Dominus-Nova/wearable-dev-board-rp2040-wireless/RP2040 PCB.pdf

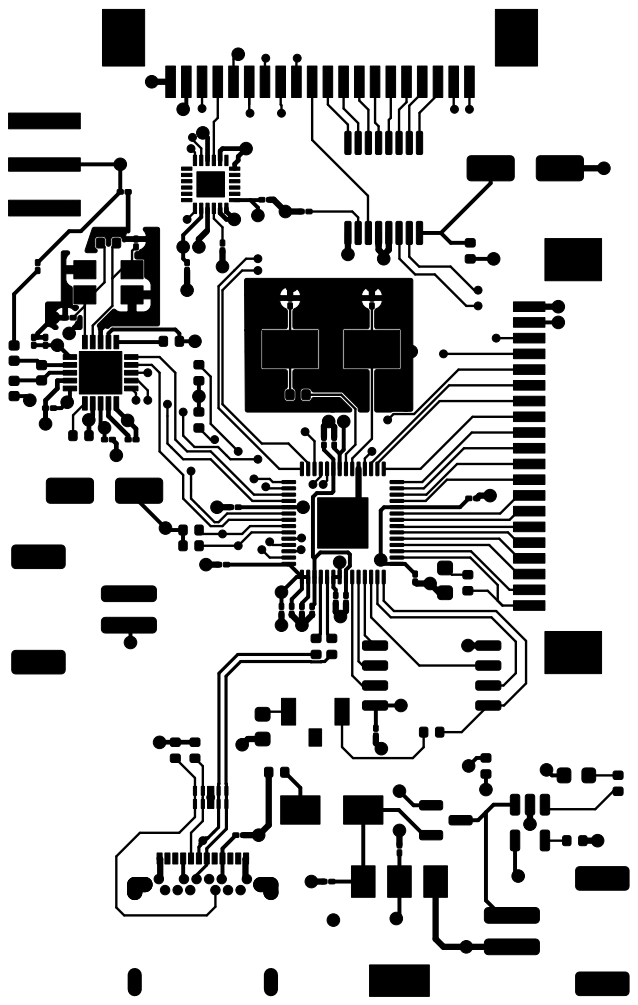
[picture p1: page 1]

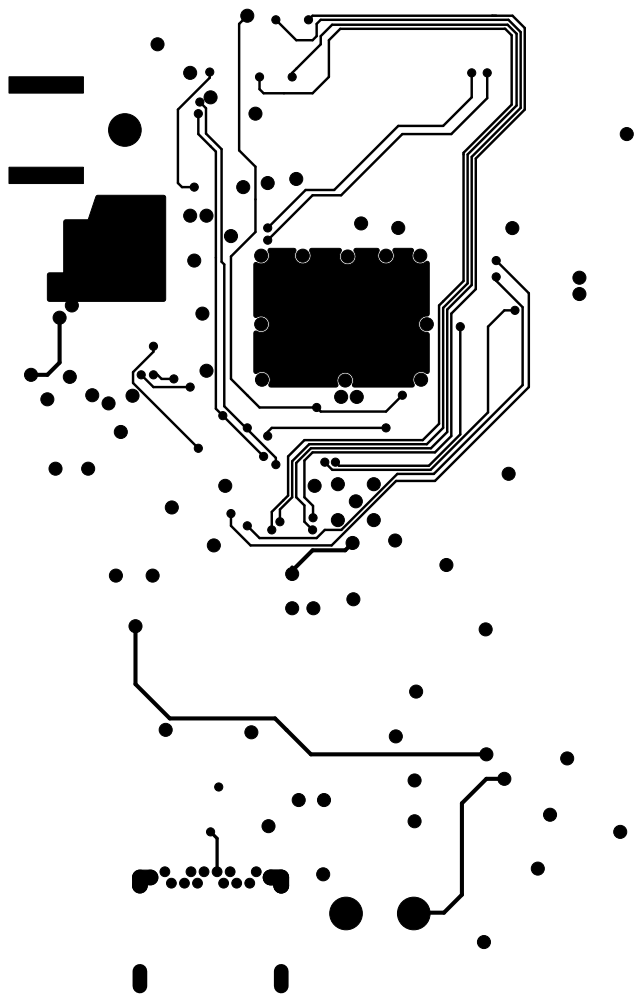
[picture p2: page 2]

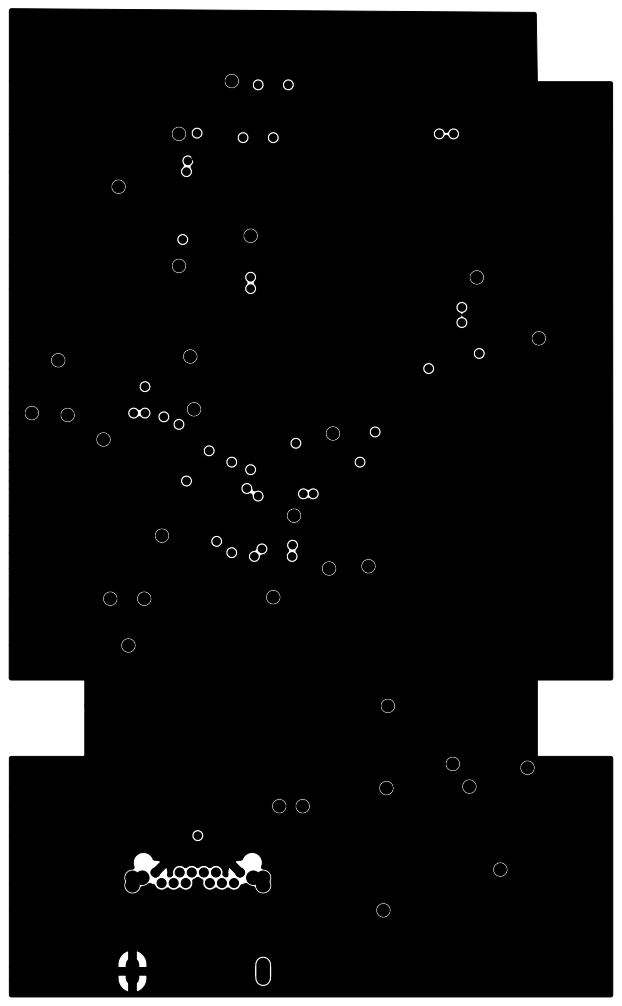
[picture p3: page 3]

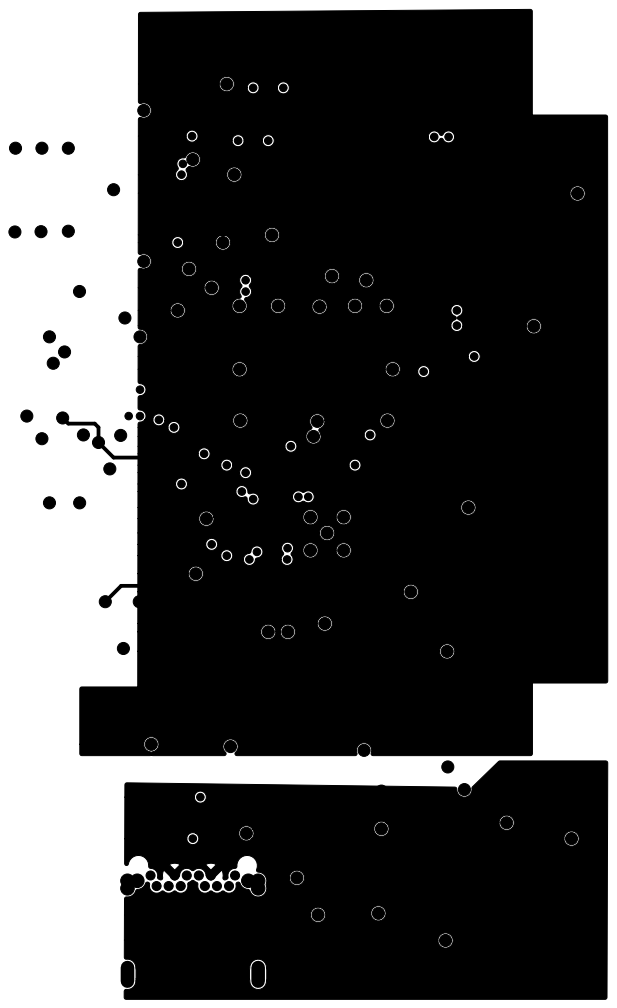
[picture p4: page 4]

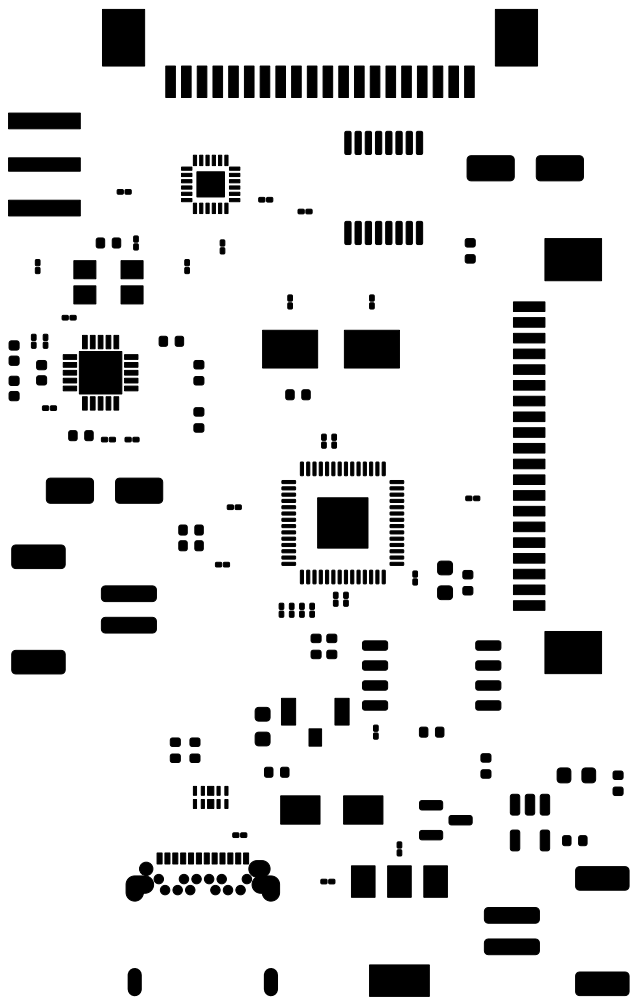
[picture p5: page 5]

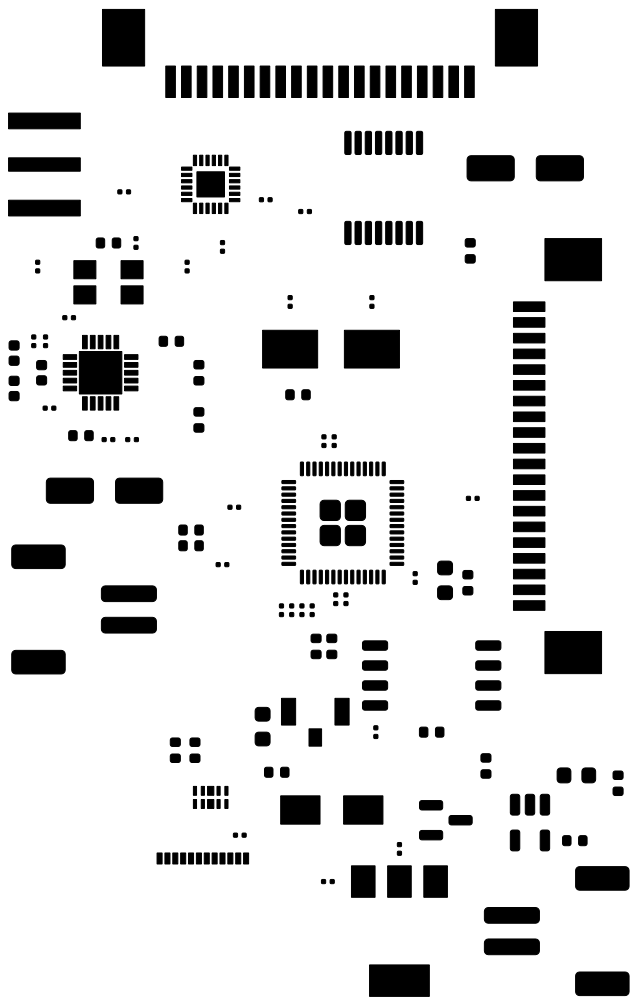
[picture p6: page 6]

# * R¹⁷

# J4 C7 C6

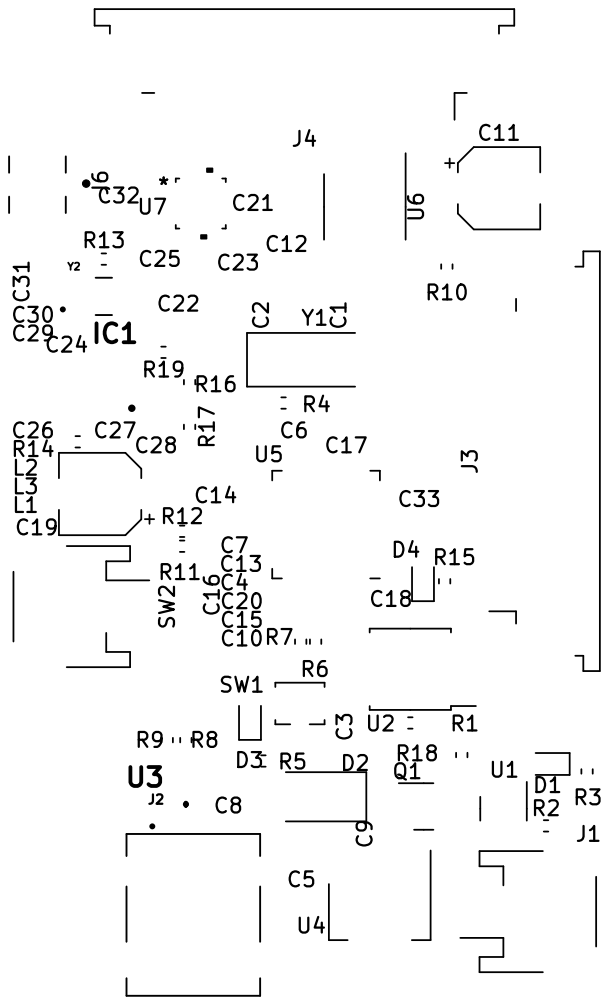
[picture p7: page 7]
