Dominus-Nova/wearable-dev-board-rp2040-wireless/Rp2040 wearable dev boards w wireless.kicad_pcb

## KiCad design Rp2040 wearable dev boards w wireless.kicad_pcb (2023-02-03)

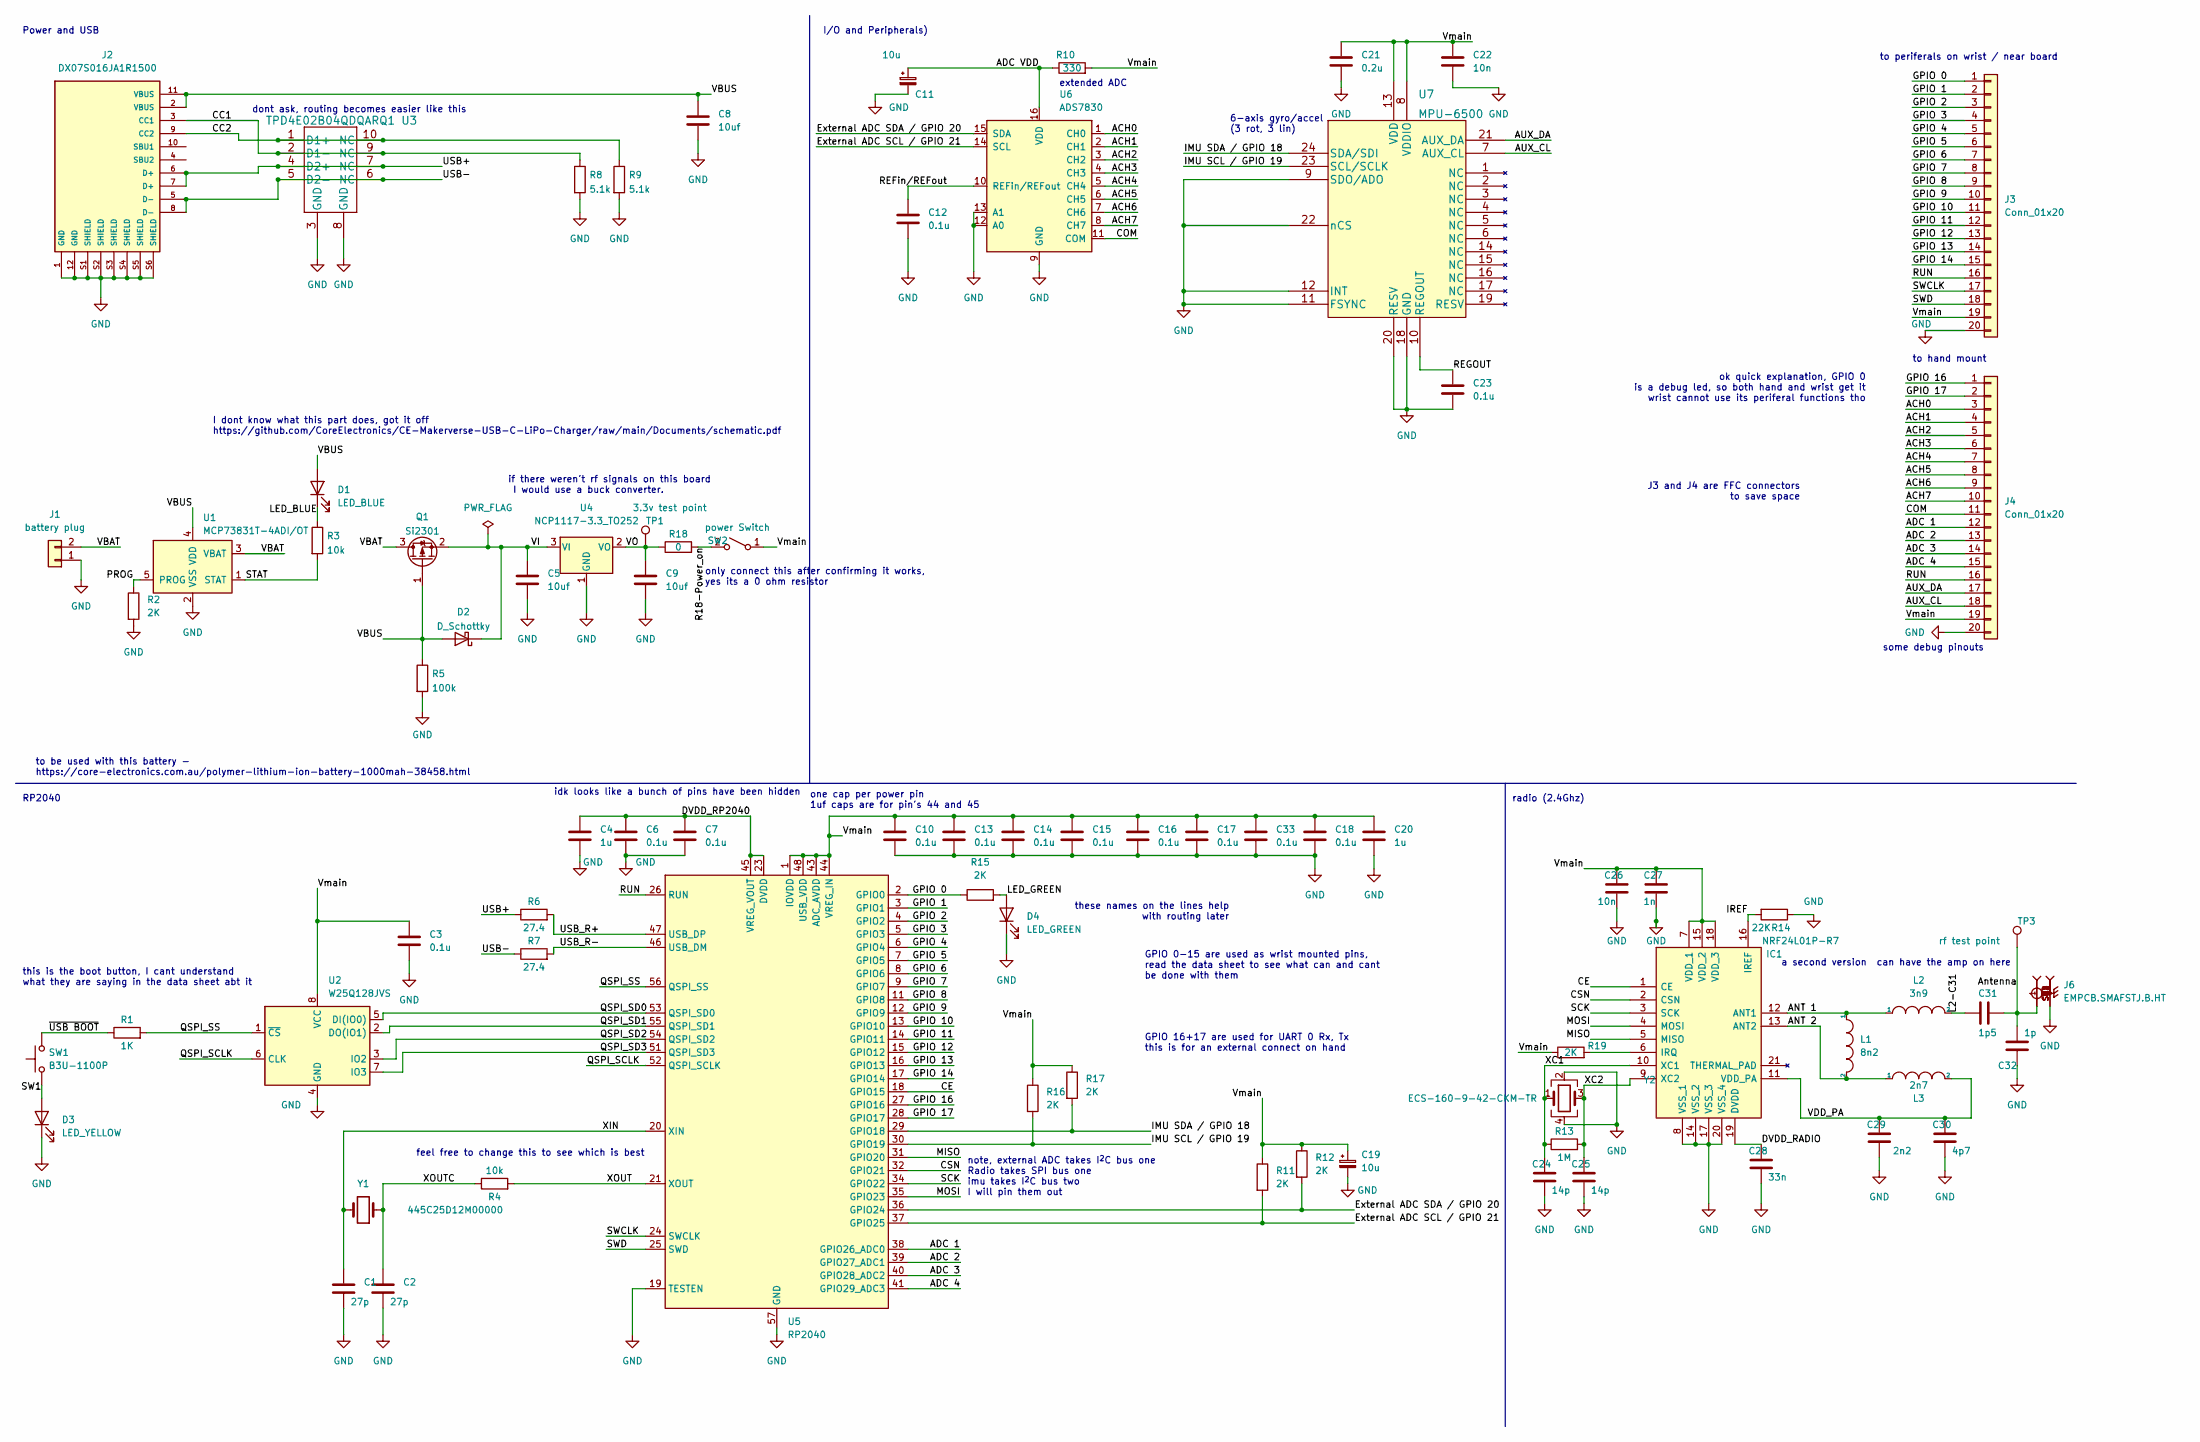
[picture p8: schematic Rp2040 wearable dev boards w wireless.kicad_sch, main]

Parts:
C1, C2: 27p; C_01005_0402Metric; Digikey Part Number 445-7173-6-ND
C3, C6, C7, C10, C12, C13, C14, C15, C16, C17, C18, C23, C33: 0.1u; C_0201_0603Metric; Digikey Part Number 490-3167-1-ND
C4, C20: 1u; C_0201_0603Metric; Digikey Part Number 478-7862-1-ND
C5, C8, C9: 10uf; C_0402_1005Metric; Digikey Part Number 490-GRM155R60J106ME05JCT-ND
C11, C19: 10u; CP_Elec_5x5.3; Digikey Part Number 732-6416-6-ND
C21: 0.2u; C_1206_3216Metric; Digikey Part Number 478-12814-1-ND
C22, C26: 10n; C_01005_0402Metric; Digikey Part Number 490-13319-1-ND
C24, C25: 14p; C_0402_1005Metric; Digikey Part Number 490-GJM1555C1H140FB01DCT-ND
C27: 1n; C_01005_0402Metric; Digikey Part Number 490-GRM022R71C102KE14LCT-ND
C28: 33n; C_01005_0402Metric; Digikey Part Number 490-9977-1-ND
C29: 2n2; C_01005_0402Metric; Digikey Part Number 490-7164-1-ND
C30: 4p7; C_01005_0402Metric; Digikey Part Number 490-13585-1-ND
C31: 1p5; C_01005_0402Metric; Digikey Part Number 490-13488-1-ND
C32: 1p; C_01005_0402Metric; Digikey Part Number 490-13474-1-ND
D1: LED_BLUE; LED_0603_1608Metric; Digikey Part Number 160-1827-1-ND
D2: D_Schottky; D_SMA; Digikey Part Number 641-1690-1-ND
D3: LED_YELLOW; LED_0603_1608Metric; Digikey Part Number 160-1448-1-ND
D4: LED_GREEN; LED_0603_1608Metric; Digikey Part Number 160-1446-1-ND
IC1: NRF24L01P-R7; QFN50P400X400X95-21N-D; Manufacturer_Part_Number NRF24L01P-R7; Mouser Part Number 949-NRF24L01P-R7
J1: battery plug; JST_PH_S2B-PH-SM4-TB_1x02-1MP_P2.00mm_Horizontal; Digikey Part Number 455-1749-1-ND
J2: DX07S016JA1R1500; JAE_DX07S016JA1R1500; PARTREV 1; Digikey Part Number 670-DX07S016JA1R1500CT-ND
J3, J4: Conn_01x20; TE_2-84952-0_1x20-1MP_P1.0mm_Horizontal; Digikey Part Number A100319CT-ND
J6: EMPCB.SMAFSTJ.B.HT; TAOGLAS_EMPCB.SMAFSTJ.B.HT; Digikey Part Number 931-1175-ND
L1: 8n2; L_0402_1005Metric; Digikey Part Number 490-6849-1-ND
L2: 3n9; L_0402_1005Metric; Digikey Part Number 490-6813-1-ND
L3: 2n7; L_0402_1005Metric; Digikey Part Number 490-6799-1-ND
Q1: Si2301; SOT-23; Digikey Part Number 353-SI2301A-TPCT-ND
R1: 1K; R_0402_1005Metric; Digikey Part Number 311-1.0KJRCT-ND
R2, R11, R12, R15, R16, R17, R19: 2K; R_0402_1005Metric; Digikey Part Number YAG2303CT-ND
R3, R4: 10k; R_0402_1005Metric; Digikey Part Number 311-10KJRCT-ND
R5: 100k; R_0402_1005Metric; Digikey Part Number 13-RC0402FR-13100KLCT-ND
R6, R7: 27.4; R_0402_1005Metric; Digikey Part Number YAG3085CT-ND
R8, R9: 5.1k; R_0402_1005Metric; Digikey Part Number 13-RC0402FR-135K1LCT-ND
R10: 330; R_0402_1005Metric; Digikey Part Number 311-330JRCT-ND
R13: 1M; R_0402_1005Metric; Digikey Part Number 311-1.0MJRCT-ND
R14: 22K; R_0402_1005Metric; Digikey Part Number 311-22.0KLRCT-ND
R18: 0; R_0402_1005Metric; Digikey Part Number 311-0.0LRCT-ND
SW1: B3U-1100P; SW_SPST_B3U-1100P; Digikey Part Number SW1021CT-ND
SW2: power Switch; JST_PH_S2B-PH-SM4-TB_1x02-1MP_P2.00mm_Horizontal; Digikey Part Number 455-1749-1-ND
TP1: 3.3v test point; TestPoint_Pad_D2.0mm; Digikey Part Number n/a
TP3: rf test point; TestPoint_Pad_D2.0mm; Digikey Part Number n/a
U1: MCP73831T-4ADI/OT; SOT-23-5; Digikey Part Number MCP73831T-4ADI/OTCT-ND
U2: W25Q128JVS; SOIC-8_5.23x5.23mm_P1.27mm; Digikey Part Number W25Q128JVSIMCT-ND
U3: TPD4E02B04QDQARQ1; Digikey Part Number 296-48995-1-ND
U4: NCP1117-3.3_TO252; SOT-223; Digikey Part Number NCP1117LPST33T3GOSCT-ND
U5: RP2040; QFN-56-1EP_7x7mm_P0.4mm_EP3.2x3.2mm; Digikey Part Number 2648-SC0914(13)CT-ND
U6: ADS7830; TSSOP-16_4.4x5mm_P0.65mm; Digikey Part Number 296-25899-1-ND
U7: MPU-6500; Digikey Part Number 1428-1011-1-ND
Y1: 445C25D12M00000; Crystal_SMD_5032-2Pin_5.0x3.2mm_HandSoldering; Digikey Part Number CTX1162CT-ND
Y2: ECS-160-9-42-CKM-TR; XTAL_ECS-160-9-42-CKM-TR; Digikey Part Number XC1611CT-ND

Connections:
/ACH0: J4.3, U6.1 (CH0)
/ACH1: J4.4, U6.2 (CH1)
/ACH2: J4.5, U6.3 (CH2)
/ACH3: J4.6, U6.4 (CH3)
/ACH4: J4.7, U6.5 (CH4)
/ACH5: J4.8, U6.6 (CH5)
/ACH6: J4.9, U6.7 (CH6)
/ACH7: J4.10, U6.8 (CH7)
/ADC 1: J4.12, U5.38 (GPIO26_ADC0)
/ADC 2: J4.13, U5.39 (GPIO27_ADC1)
/ADC 3: J4.14, U5.40 (GPIO28_ADC2)
/ADC 4: J4.15, U5.41 (GPIO29_ADC3)
/ADC VDD: C11.1, R10.1, U6.16 (VDD)
/ANT 1: IC1.12 (ANT1), L1.1, L2.1
/ANT 2: IC1.13 (ANT2), L1.2, L3.1
/AUX_CL: J4.18, U7.7 (AUX_CL)
/AUX_DA: J4.17, U7.21 (AUX_DA)
/Antenna: C31.2, C32.1, J6.1, TP3.1; also elsewhere on the board
/CC1: J2.3 (CC1), R8.1, U3.2 (D1-), U3.9 (NC)
/CC2: J2.9 (CC2), R9.1, U3.1 (D1+), U3.10 (NC)
/CE: IC1.1 (CE), U5.18 (GPIO15)
/COM: J4.11, U6.11 (COM)
/CSN: IC1.2 (CSN), U5.32 (GPIO21)
/DVDD_RADIO: C28.1, IC1.19 (DVDD)
/DVDD_RP2040: C4.1, C6.1, C7.1, U5.23 (DVDD), U5.45 (VREG_VOUT), U5.50 (DVDD)
/External ADC SCL / GPIO 21: R11.2, U5.37 (GPIO25), U6.14 (SCL)
/External ADC SDA / GPIO 20: R12.2, U5.36 (GPIO24), U6.15 (SDA)
/GPIO 0: J3.1, R15.1, U5.2 (GPIO0)
/GPIO 1: J3.2, U5.3 (GPIO1)
/GPIO 2: J3.3, U5.4 (GPIO2)
/GPIO 3: J3.4, U5.5 (GPIO3)
/GPIO 4: J3.5, U5.6 (GPIO4)
/GPIO 5: J3.6, U5.7 (GPIO5)
/GPIO 6: J3.7, U5.8 (GPIO6)
/GPIO 7: J3.8, U5.9 (GPIO7)
/GPIO 8: J3.9, U5.11 (GPIO8)
/GPIO 9: J3.10, U5.12 (GPIO9)
/GPIO 10: J3.11, U5.13 (GPIO10)
/GPIO 11: J3.12, U5.14 (GPIO11)
/GPIO 12: J3.13, U5.15 (GPIO12)
/GPIO 13: J3.14, U5.16 (GPIO13)
/GPIO 14: J3.15, U5.17 (GPIO14)
/GPIO 16: J4.1, U5.27 (GPIO16)
/GPIO 17: J4.2, U5.28 (GPIO17)
/IMU SCL / GPIO 19: R16.2, U5.30 (GPIO19), U7.23 (SCL/SCLK)
/IMU SDA / GPIO 18: R17.2, U5.29 (GPIO18), U7.24 (SDA/SDI)
/IREF: IC1.16 (IREF), R14.2
/L2-C31: C31.1, L2.2
/LED_BLUE: D1.1 (K), R3.1
/LED_GREEN: D4.2 (A), R15.2
/MISO: IC1.5 (MISO), U5.31 (GPIO20)
/MOSI: IC1.4 (MOSI), U5.35 (GPIO23)
/PROG: R2.1, U1.5 (PROG)
/QSPI_SCLK: U2.6 (CLK), U5.52 (QSPI_SCLK)
/QSPI_SD0: U2.5 (DI(IO0)), U5.53 (QSPI_SD0)
/QSPI_SD1: U2.2 (DO(IO1)), U5.55 (QSPI_SD1)
/QSPI_SD2: U2.3 (IO2), U5.54 (QSPI_SD2)
/QSPI_SD3: U2.7 (IO3), U5.51 (QSPI_SD3)
/QSPI_SS: R1.2, U2.1 (~CS), U5.56 (QSPI_SS)
/R18-Power_on: R18.2, SW2.2 (B)
/REFin/REFout: C12.1, U6.10 (REFin/REFout)
/REGOUT: C23.1, U7.10 (REGOUT)
/RUN: J3.16, J4.16, U5.26 (RUN)
/SCK: IC1.3 (SCK), U5.34 (GPIO22)
/STAT: R3.2, U1.1 (STAT)
/SW1: D3.2 (A), SW1.1
/SWCLK: J3.17, U5.24 (SWCLK)
/SWD: J3.18, U5.25 (SWD)
/USB+: J2.6 (D+), J2.7 (D+), R6.1, U3.4 (D2+), U3.7 (NC)
/USB-: J2.5 (D-), J2.8 (D-), R7.1, U3.5 (D2-), U3.6 (NC)
/USB_R+: R6.2, U5.47 (USB_DP)
/USB_R-: R7.2, U5.46 (USB_DM)
/VBAT: J1.2, Q1.3 (D), U1.3 (VBAT)
/VBUS: C8.1, D1.2 (A), D2.2 (A), J2.2 (VBUS), J2.11 (VBUS), Q1.1 (G), R5.1, U1.4 (VDD)
/VDD_PA: C29.1, C30.1, IC1.11 (VDD_PA), L3.2
/VI: C5.1, D2.1 (K), Q1.2 (S), U4.3 (VI)
/VO: C9.1, R18.1, TP1.1, U4.2 (VO)
/Vmain: C3.1, C10.1, C13.1, C14.1, C15.1, C16.1, C17.1, C18.1, C19.1, C20.1, C21.1, C22.1, C26.1, C27.1, C33.1, IC1.7 (VDD_1), IC1.15 (VDD_2), IC1.18 (VDD_3), J3.19, J4.19, R10.2, R11.1, R12.1, R16.1, R17.1, R19.1, SW2.1 (A), U2.8 (VCC), U5.1 (IOVDD), U5.10 (IOVDD), U5.22 (IOVDD), U5.33 (IOVDD), U5.42 (IOVDD), U5.43 (ADC_AVDD), U5.44 (VREG_IN), U5.48 (USB_VDD), U5.49 (IOVDD), U7.8 (VDDIO), U7.13 (VDD)
/XC1: C24.1, IC1.10 (XC1), R13.1, Y2.1
/XC2: C25.1, IC1.9 (XC2), R13.2, Y2.3
/XIN: C1.1, U5.20 (XIN), Y1.2
/XOUT: R4.2, U5.21 (XOUT)
/XOUTC: C2.1, R4.1, Y1.1
/~USB BOOT: R1.1, SW1.2
GND: C1.2, C2.2, C3.2, C4.2, C5.2, C6.2, C7.2, C8.2, C9.2, C10.2, C11.2, C12.2, C13.2, C14.2, C15.2, C16.2, C17.2, C18.2, C19.2, C20.2, C21.2, C22.2, C23.2, C24.2, C25.2, C26.2, C27.2, C28.2, C29.2, C30.2, C32.2, C33.2, D3.1 (K), D4.1 (K), IC1.8 (VSS_1), IC1.14 (VSS_2), IC1.17 (VSS_3), IC1.20 (VSS_4), J1.1, J2.1 (GND), J2.12 (GND), J2.S1 (SHIELD), J2.S2 (SHIELD), J2.S3 (SHIELD), J2.S4 (SHIELD), J2.S5 (SHIELD), J2.S6 (SHIELD), J3.20, J4.20, J6.SH1, J6.SH2, J6.SH3, J6.SH4, R2.2, R5.2, R8.2, R9.2, R14.1, U1.2 (VSS), U2.4 (GND), U3.3 (GND), U3.8 (GND), U4.1 (GND), U5.19 (TESTEN), U5.57 (GND), U6.9 (GND), U6.12 (A0), U6.13 (A1), U7.9 (SDO/ADO), U7.11 (FSYNC), U7.12 (INT), U7.18 (GND), U7.20 (RESV), U7.22 (nCS), Y2.2, Y2.4; also elsewhere on the board
unnamed: IC1.6 (IRQ), R19.2

Notes on the sheet:
I dont know what this part does, got it off https://github.com/CoreElectronics/CE-Makerverse-USB-C-LiPo-Charger/raw/main/Documents/schematic.pdf
6-axis gyro/accel (3 rot, 3 lin)
dont ask, routing becomes easier like this
radio (2.4Ghz)
if there weren't rf signals on this board I would use a buck converter.
note, external ADC takes I^{2}C bus one Radio takes SPI bus one imu takes I^{2}C bus two I will pin them out
this is the boot button, I cant understand what they are saying in the data sheet abt it
idk looks like a bunch of pins have been hidden
a second version can have the amp on here
extended ADC
I/O and Peripherals)
RP2040
these names on the lines help with routing later
GPIO 0-15 are used as wrist mounted pins, read the data sheet to see what can and cant be done with them
only connect this after confirming it works, yes its a 0 ohm resistor
some debug pinouts
to periferals on wrist / near board
one cap per power pin 1uf caps are for pin's 44 and 45
feel free to change this to see which is best
to be used with this battery - https://core-electronics.com.au/polymer-lithium-ion-battery-1000mah-38458.html
Power and USB
J3 and J4 are FFC connectors to save space
to hand mount
ok quick explanation, GPIO 0 is a debug led, so both hand and wrist get it wrist cannot use its periferal functions tho
GPIO 16+17 are used for UART 0 Rx, Tx this is for an external connect on hand

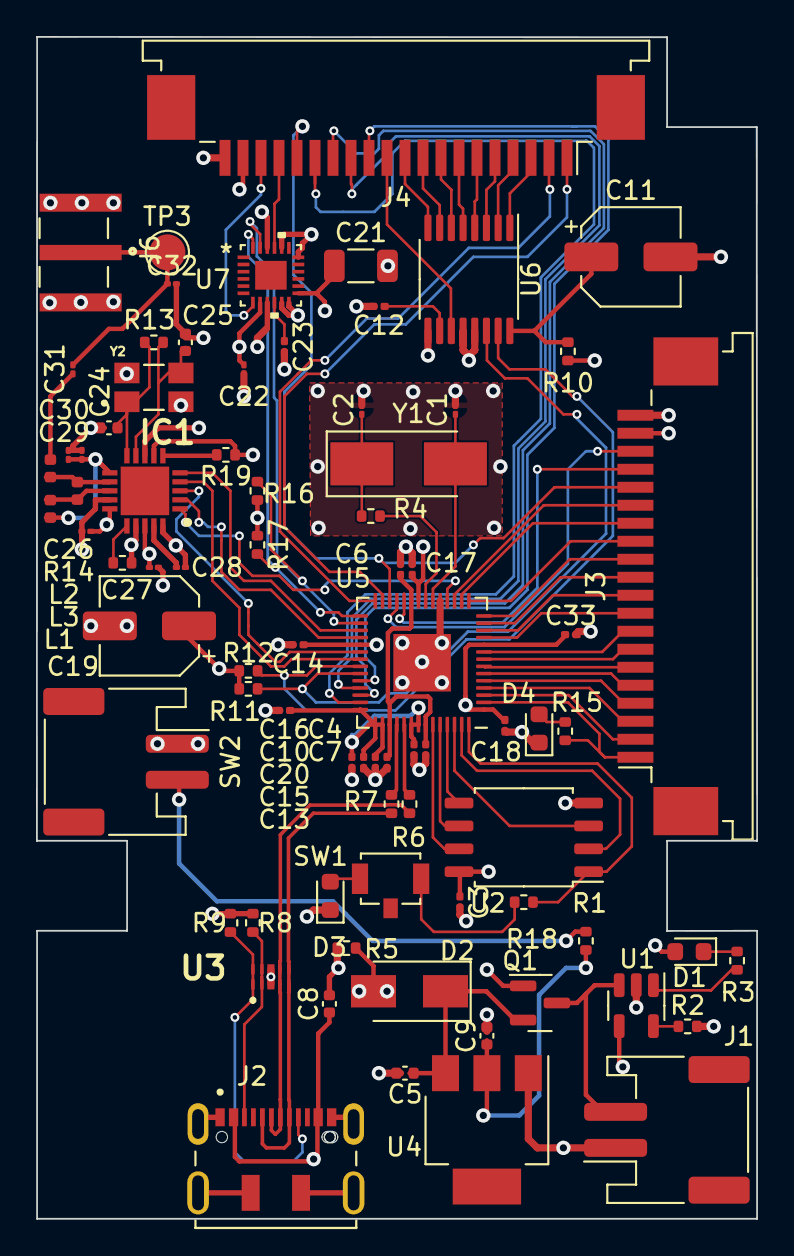
[picture p9: board Rp2040 wearable dev boards w wireless.kicad_pcb from above]

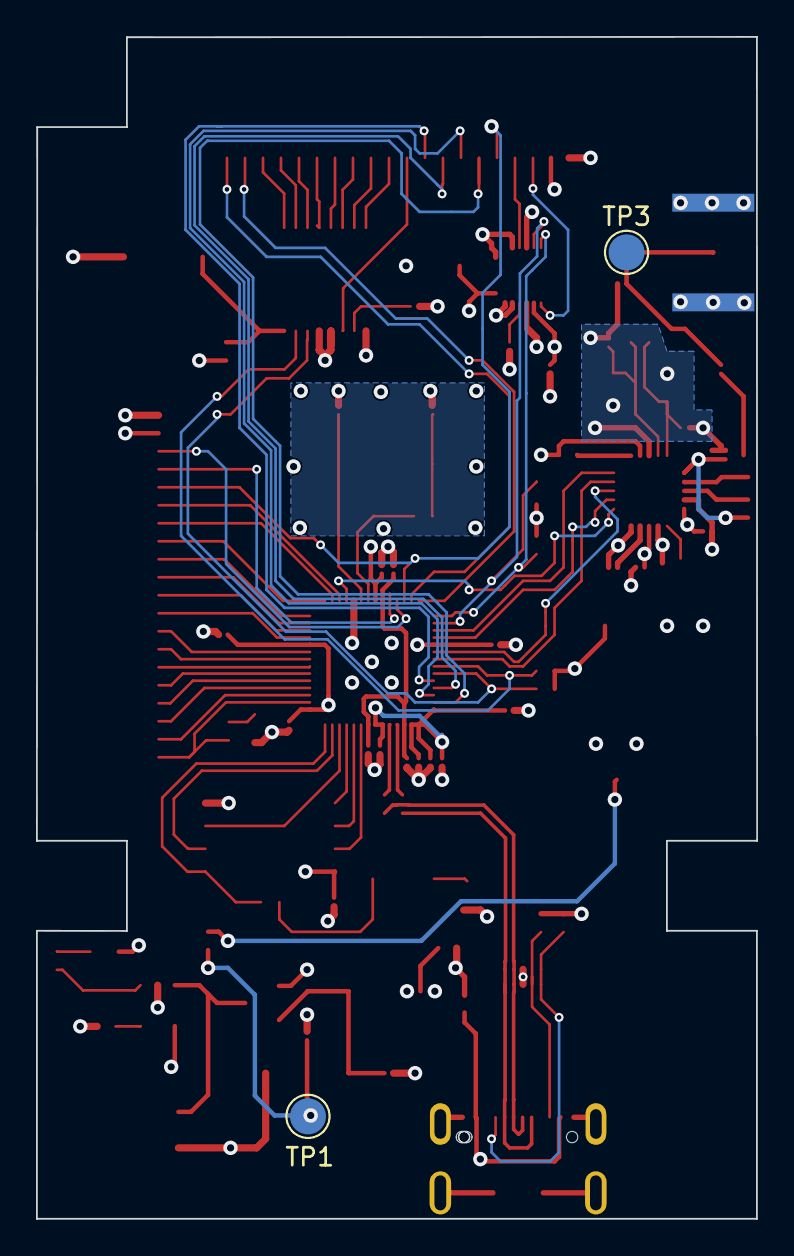
[picture p10: board Rp2040 wearable dev boards w wireless.kicad_pcb from below]

Board: 4 copper layers, 40.0 x 65.7 mm, 80 parts (2 on the bottom side), 86 nets.

Other parts of the board:
TP3#2: rf test point; TestPoint_Pad_D2.0mm

Their connections:
/Antenna: TP3#2.1; also elsewhere on the board
GND: TP3#2.1; also elsewhere on the board
