Dominus-Nova/wearable-dev-board-rp2040-wireless/(commit log)

2022-11-17 started work on adc
    [Rp2040 wearable dev boards w wireless.kicad_sch]
2022-11-17 yeh, stuff happened finished rp2040 pinout, added the IMU that is going to be used, created a set of solder pads (x21) for the GPIO
    [Rp2040 wearable dev boards w wireless.kicad_sch]
2022-11-17 finnished preiferals added names and pads
    [Rp2040 wearable dev boards w wireless.kicad_sch]
2022-11-18 finished schematic v.1 about to start routing
    [Rp2040 wearable dev boards w wireless.kicad_pcb, Rp2040 wearable dev boards w wireless.kicad_sch]
2022-11-18 finished schematic started pcb design, will need to review the power section.
    [Rp2040 wearable dev boards w wireless.kicad_pcb, Rp2040 wearable dev boards w wireless.kicad_sch]
2022-11-19 mmmmmmmmmmm change log.exe
    [Rp2040 wearable dev boards w wireless.kicad_pcb, Rp2040 wearable dev boards w wireless.kicad_sch]
2022-11-19 routed power
    [Rp2040 wearable dev boards w wireless.kicad_pcb, Rp2040 wearable dev boards w wireless.kicad_sch]
2022-11-20 started pinning out Rp2040 shortened board to 60 something long
    [Rp2040 wearable dev boards w wireless.kicad_pcb, Rp2040 wearable dev boards w wireless.kicad_sch]
2022-11-23 finished pcb route v1, asked the electronics discord if they could verify it.
    [Rp2040 wearable dev boards w wireless.kicad_pcb, Rp2040 wearable dev boards w wireless.kicad_sch]
2022-11-24 finished cap bom, need to reroute part of it to fit cap sizes
    [Rp2040 wearable dev boards w wireless.kicad_pcb, Rp2040 wearable dev boards w wireless.kicad_sch]
2022-11-26 more bom creation
    [Rp2040 wearable dev boards w wireless.kicad_pcb, Rp2040 wearable dev boards w wireless.kicad_sch]
2023-02-03 uhhh forgot to do this for a while, this was the first manufactured prototype
    [BOM-Rp2040 wearable dev boards w wireless.csv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]
